Hado3728/Hado-Titan-v2/JOURNAL/SCREENSHOT DUMP/Laser cut gear system.jpeg

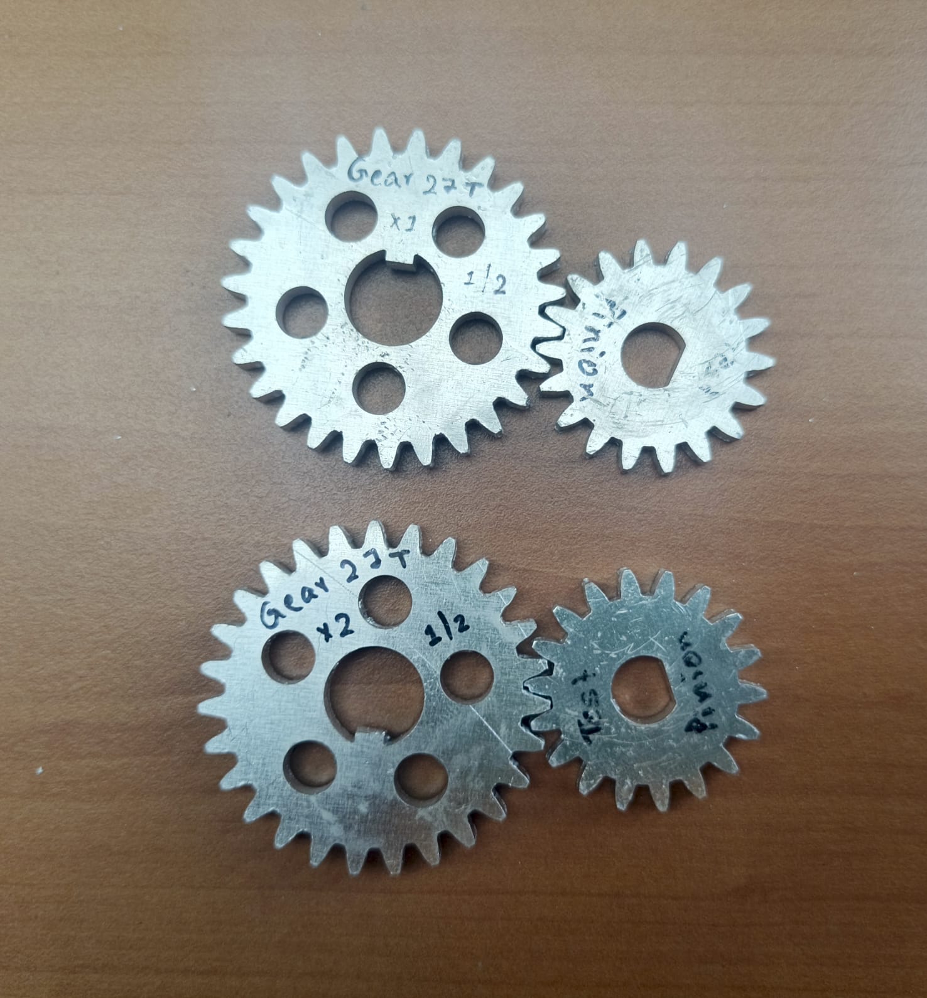
JOURNAL/SCREENSHOT DUMP/Laser cut gear system.jpeg
