Hado3728/Hado-Titan-v2/README.md

# Hado Titan V2

###### An 8 kg invertible drum spinner. The steel drum is belt driven and the chassis is laser-cut, bent sheet aluminium.



|Weight|7.78 kg of 8 kg (218 g spare, wiring included)|
|-|-|
|Size|386 × 268 × 100 mm|
|Weapon|Spinning drum|
|Weapon numbers|7,640 rpm, 539 J, 31 m/s at the tips, 0.9 s spin-up|
|Drive|2 × PG36M555 gearmotors  18:27 laser-cut gears|
|Battery|6S 2500 mAh 35C. A hard 5-minute fight.|

#### DRIVE GEAR SYSTEM (READY)

Laser cut gear system

## How it works

It basically is a two wheel driven combat bot, with a HR steel front single drum spinner with two protrusions. It is driven by a 5M HTD belt connected to a weapon motor inside the main bot. The weight distribution on to the ground is at two points, mainly the  wheels and the forks. The two wheels hold upto 75% of the total body weight of the bot whereas the forks hold the remaining weight. The order in which the bot works is that the forks elevate the opponent and then fed towards the drum spinner for the impact. The forks are shaped to work as a hook to latch on to the opponents to pull the other bot for maximum control. It is powered by a LiPO 6S 2500mah battery at the rear end of the bot which is protected with TPU fins about 30mm in length, and also the battery is also insulated with a EVA foam against the metal exterior.

## BOM

|Section|₹|
|-|-:|
|Electronics|29,817|
|Machining (CNC drum, heat treat, lathe parts)|12,241|
|Bought mechanical (bearings, belts, tyres, foam)|2,530|
|Wiring|2,417|
|Fasteners|1,771|
|Metal, laser cut + bent (₹375/kg)|1,621|
|3D printing (TPU)|1,360|
|Charger (only if needed)|3,043|
|Total|$616|

Approx value, it will prolly be lesser than $616 since i'm pitching my own allowance too (I already ordered the laser cut parts, and i even got em delivered) 

## Weight

|Group|g|
|-|-:|
|Drum, shaft, bearings, spacers|2326|
|Drive (gearmotors, gears, bulkheads, saddles)|1062|
|Tub, rear wall, splices|903|
|Wheels, axles, bearings, doublers|616|
|Weapon motor, pulley, belt, mount|613|
|Weapon uprights|602|
|Electronics|536|
|Lid|401|
|Fasteners|265|
|Forks|164|
|TPU cradles + foam|154|
|Wiring|140|
|Total|7782|
THESE HAVE CHANGED (SO ABOUT 100 GM +-) 

ALL THE LASER CUT PARTS DELIVERED
WhatsApp Image 2026-11-10 at 12 16 42 PM
