Hado3728/Hado-Titan-v2/JOURNAL/SCREENSHOT DUMP/BOM3.png

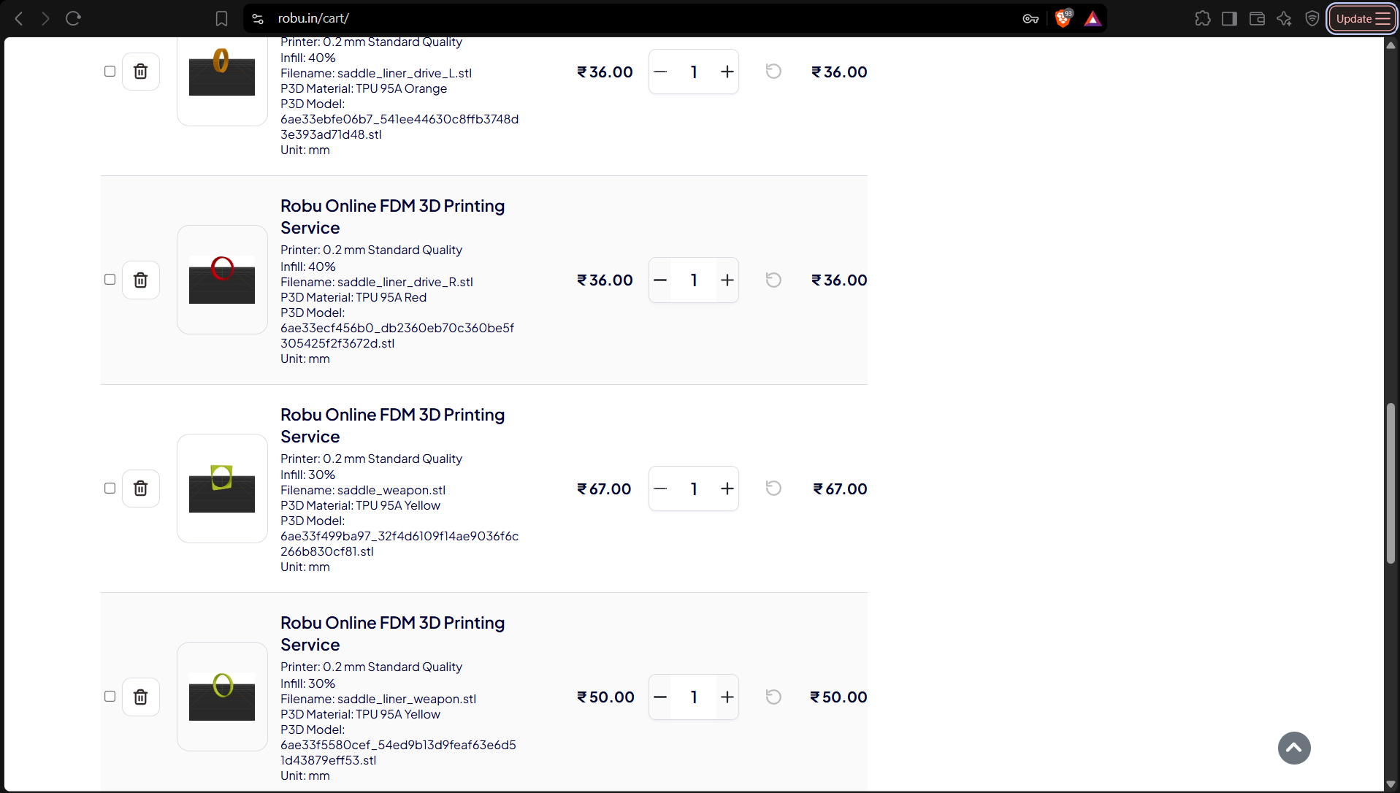
JOURNAL/SCREENSHOT DUMP/BOM3.png
