Hado3728/Hado-Titan-v2/JOURNAL/SCREENSHOT DUMP/BOM4.png

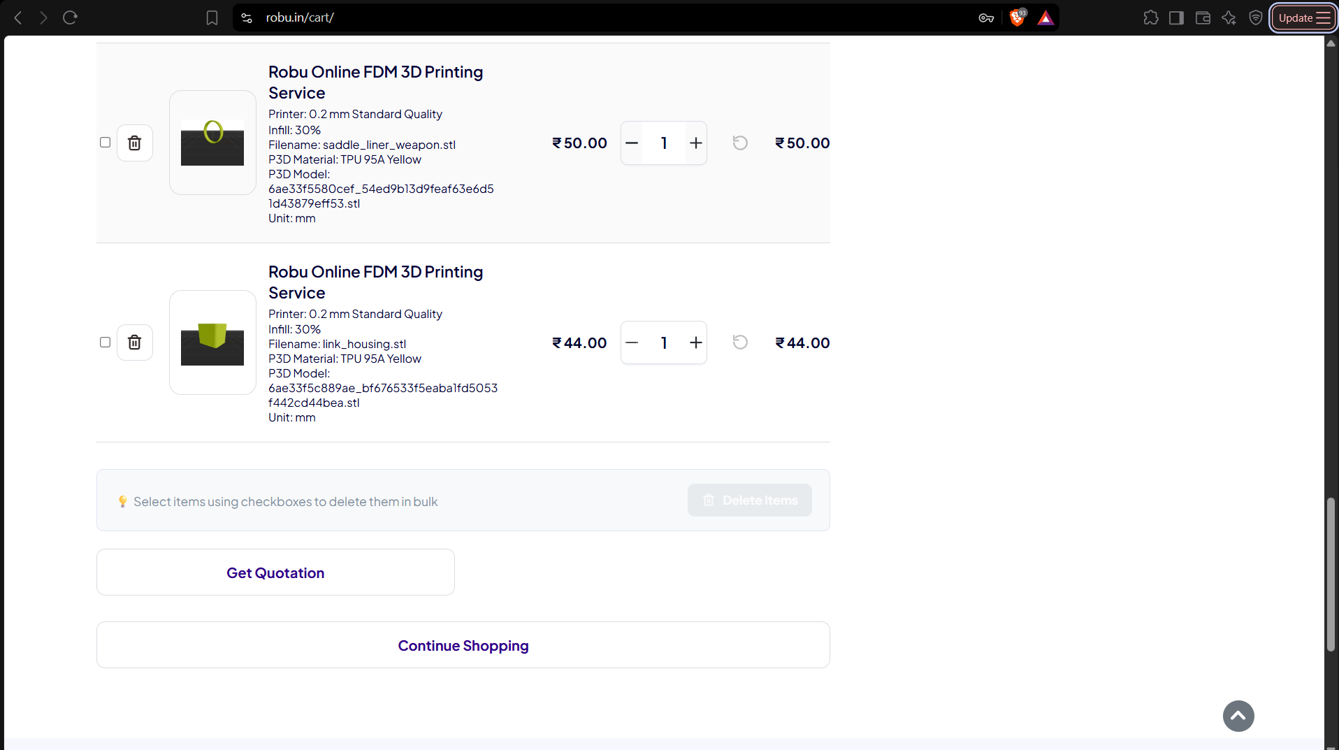
JOURNAL/SCREENSHOT DUMP/BOM4.png
