Hado3728/Hado-Titan-v2/CAD/hado_titan_v2_assembly.step

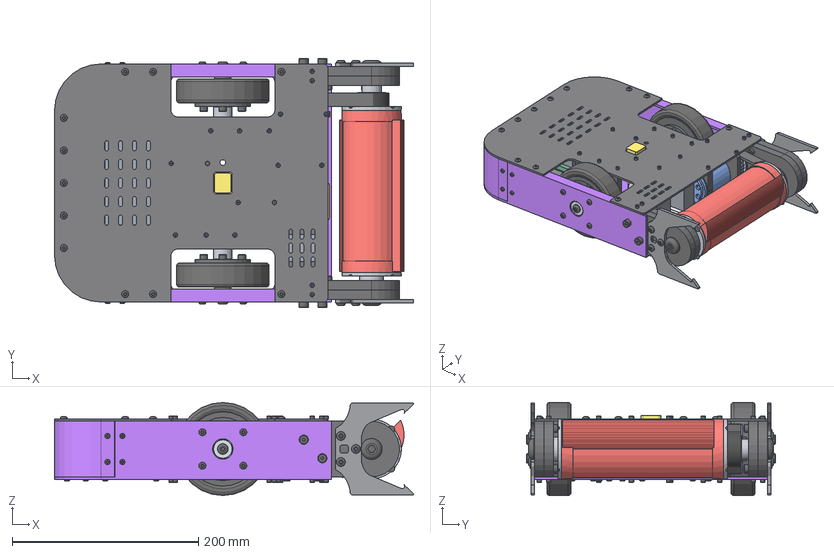
[picture p6: CAD file, 2026-11-03]
CAD/hado_titan_v2_assembly.step
386.0 x 268.0 x 100.0 mm
tub
lid
upright_inner_L
upright_outer_L
upright_inner_R
upright_outer_R
fork_L
fork_R
bearing_drum_L
belt
weapon_motor
weapon_mount
saddle_weapon
saddle_liner_weapon
gearmotor_L
gearmotor_R
bulkhead_L
bulkhead_R
axle_L
bearing_axle_in_L
bearing_axle_out_L
spacer_axle_out_L
doubler_L
retainer_L
washer_axle_L
axle_R
bearing_axle_in_R
bearing_axle_out_R
spacer_axle_out_R
doubler_R
retainer_R
washer_axle_R
saddle_drive_L
saddle_liner_drive_L
saddle_drive_R
saddle_liner_drive_R
cradle_mdds10
foam_mdds10
mdds10
cradle_battery
foam_battery
battery
cradle_zerodrag
foam_zerodrag
zerodrag
cradle_receiver
foam_receiver
receiver
link_housing
link_plug
screw_lid_1
screw_lid_2
screw_lid_3
screw_lid_4
screw_lid_5
screw_lid_6
screw_lid_7
screw_lid_8
screw_lid_9
screw_lid_10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
