Hado3728/Hado-Titan-v2/CAD/3D PRINT SKIRT/side_fin_skirt_R_TPU.step

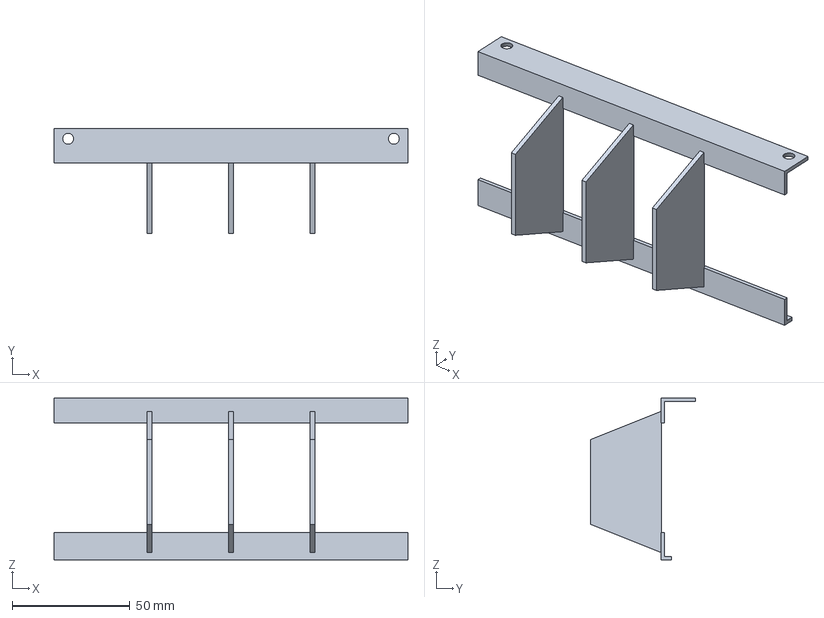
[picture p7: CAD file, 2026-11-03]
CAD/3D PRINT SKIRT/side_fin_skirt_R_TPU.step
150.0 x 44.3 x 68.5 mm
