Hado3728/Hado-Titan-v2/CAD/PARTS/axle_L.step

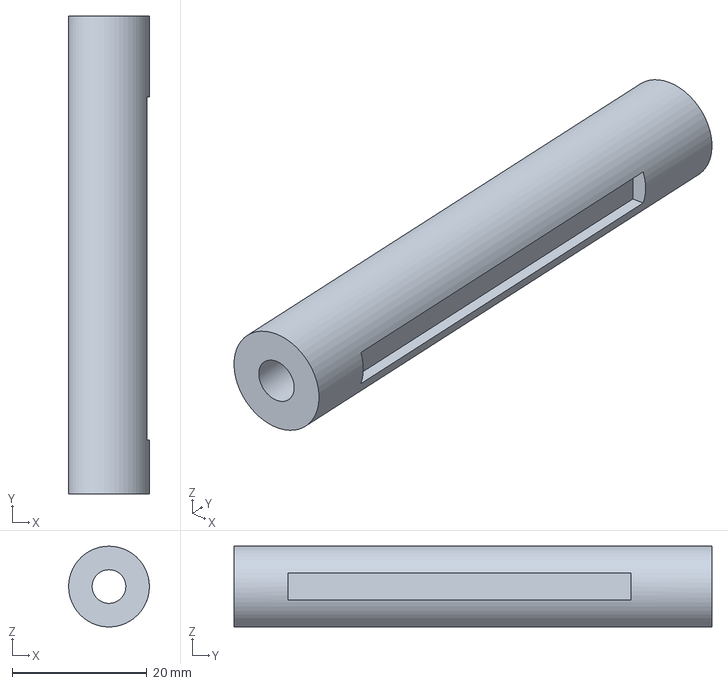
[picture p8: CAD file, 2026-11-03]
CAD/PARTS/axle_L.step
12.0 x 71.0 x 12.0 mm
