Hado3728/Hado-Titan-v2/CAD/PROTECTIVE SLEEVES/drum_tooth_sleeve_TPU_x2.step

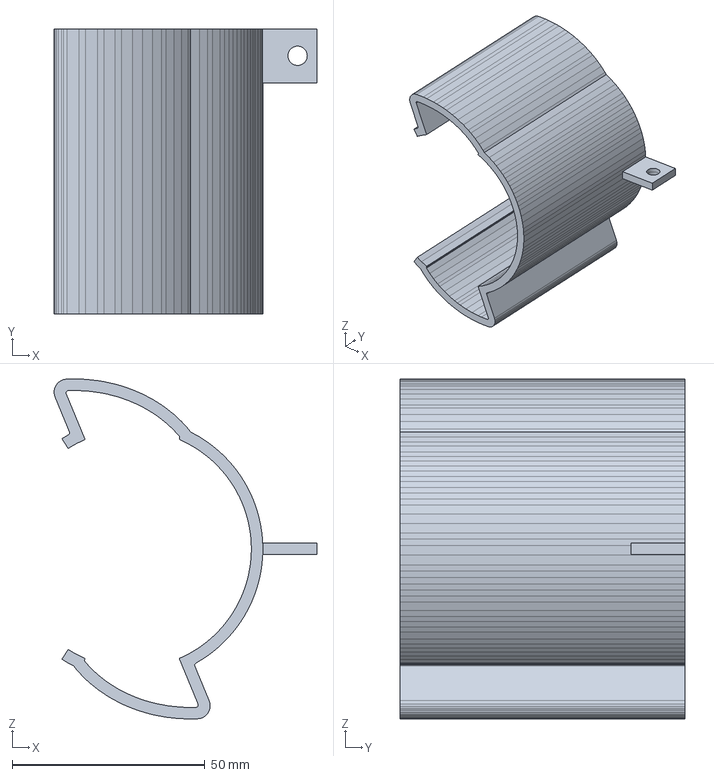
[picture p9: CAD file, 2026-11-03]
CAD/PROTECTIVE SLEEVES/drum_tooth_sleeve_TPU_x2.step
68.1 x 74.0 x 88.1 mm
