Hado3728/Hado-Titan-v2/CAD/PARTS/cradle_mdds10.step

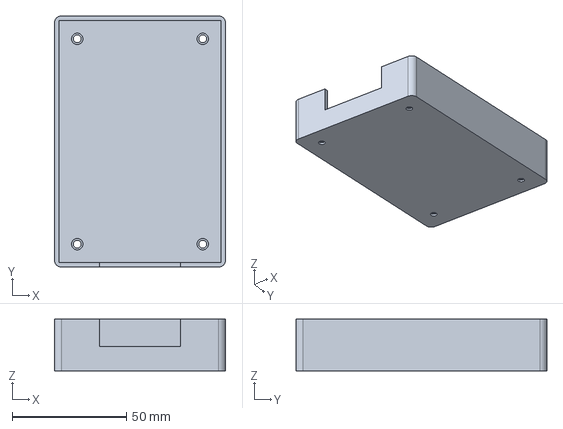
[picture p10: CAD file, 2026-11-03]
CAD/PARTS/cradle_mdds10.step
75.0 x 110.0 x 22.8 mm
