Hado3728/Hado-Titan-v2/CAD/PROTECTIVE SLEEVES/fork_tip_clip_TPU_x4.step

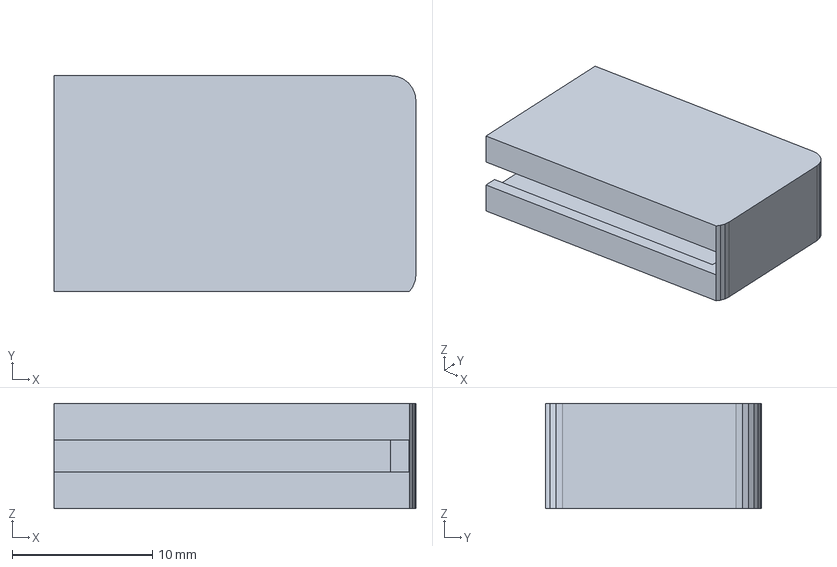
[picture p11: CAD file, 2026-11-03]
CAD/PROTECTIVE SLEEVES/fork_tip_clip_TPU_x4.step
25.8 x 15.4 x 7.50 mm
