Hado3728/Hado-Titan-v2/CAD/3D PRINT SKIRT/rear_fin_skirt_TPU.step

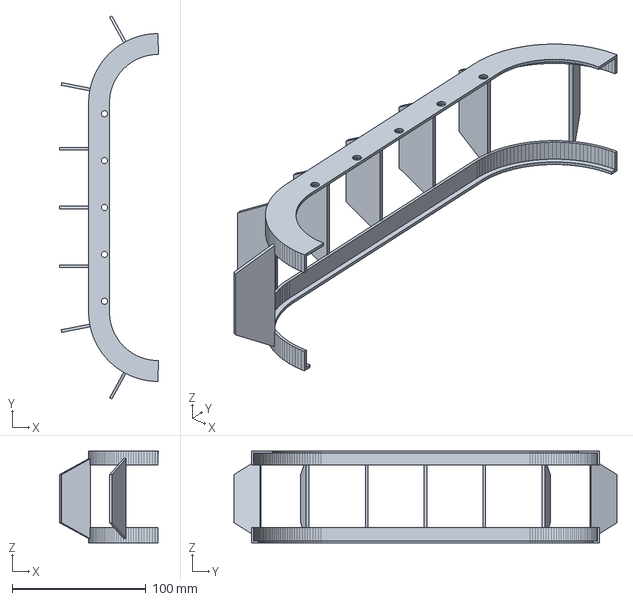
[picture p12: CAD file, 2026-11-03]
CAD/3D PRINT SKIRT/rear_fin_skirt_TPU.step
73.8 x 286.0 x 68.5 mm
