Hado3728/Hado-Titan-v2/CAD/PARTS/saddle_liner_drive_R.step

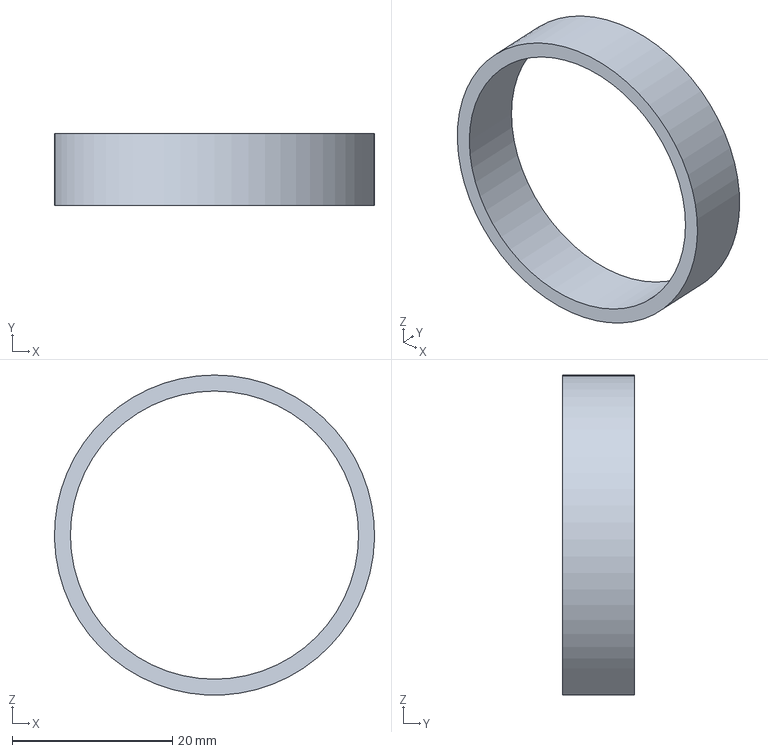
[picture p13: CAD file, 2026-11-03]
CAD/PARTS/saddle_liner_drive_R.step
40.0 x 9.00 x 40.0 mm
