Hado3728/Hado-Titan-v2/CAD/PARTS/retainer_R.step

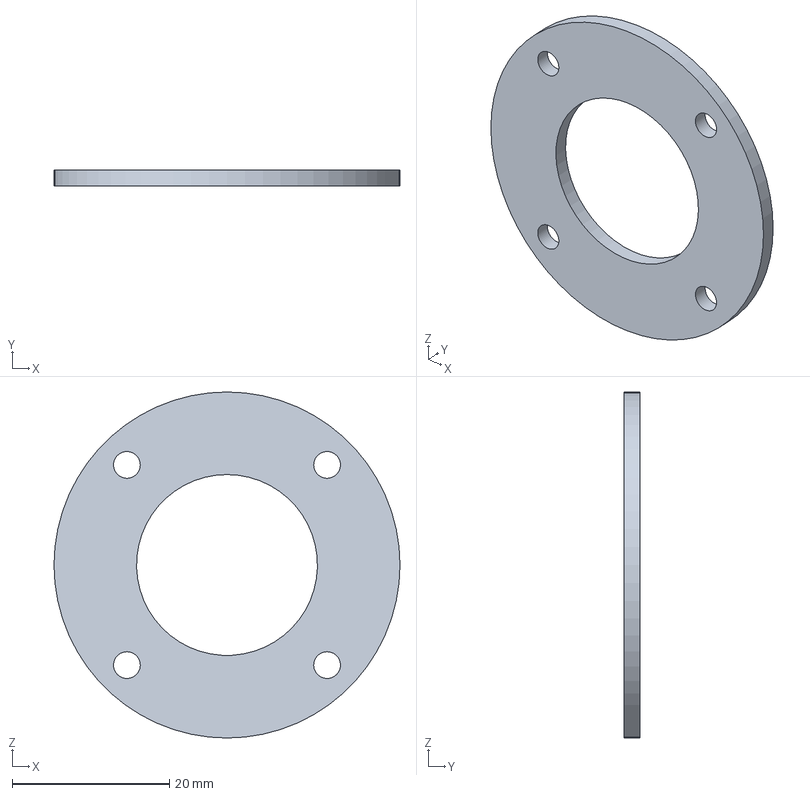
[picture p14: CAD file, 2026-11-03]
CAD/PARTS/retainer_R.step
44.0 x 2.00 x 44.0 mm
