Hado3728/Hado-Titan-v2/CAD/PARTS/tub.step

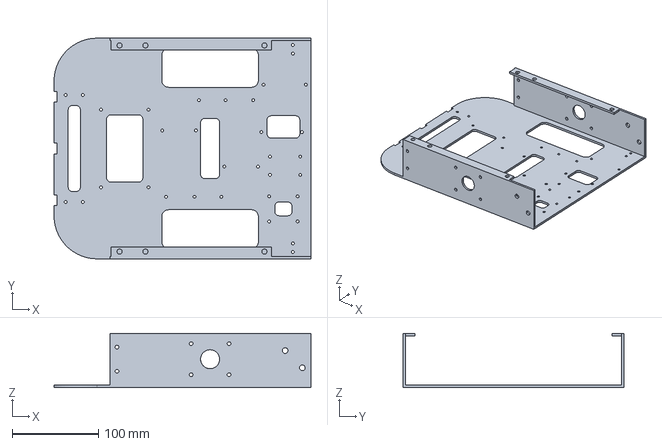
[picture p15: CAD file, 2026-11-03]
CAD/PARTS/tub.step
298.0 x 256.0 x 63.0 mm
