Hado3728/Hado-Titan-v2/CAD/PARTS/spacer_drum_L.step

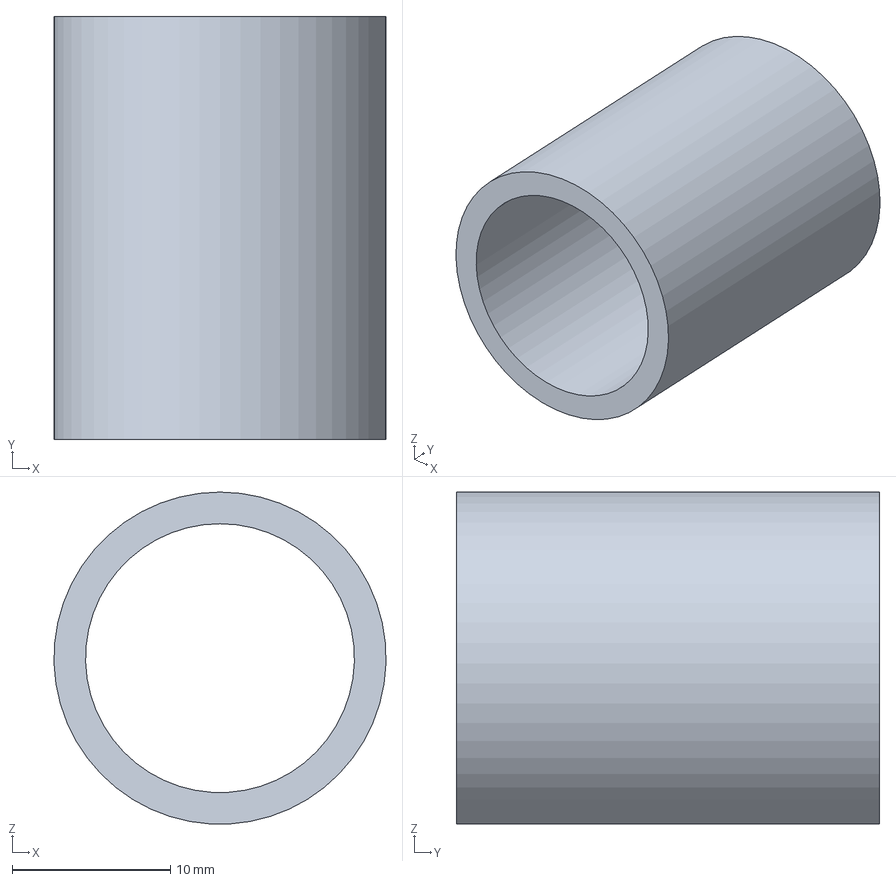
[picture p16: CAD file, 2026-11-03]
CAD/PARTS/spacer_drum_L.step
21.0 x 26.8 x 21.0 mm
