Hado3728/Hado-Titan-v2/CAD/PARTS/belt.step

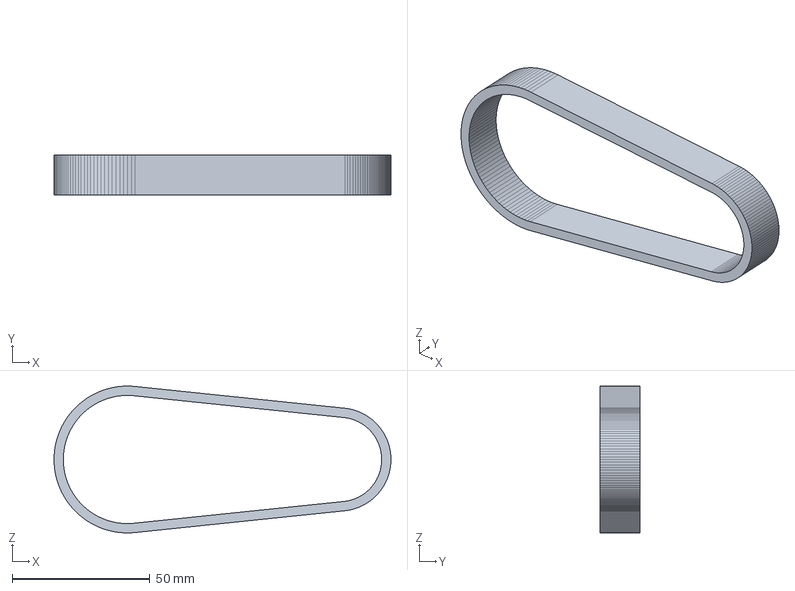
[picture p17: CAD file, 2026-11-03]
CAD/PARTS/belt.step
122.5 x 14.6 x 53.4 mm
