Hado3728/Hado-Titan-v2/CAD/PARTS/motor_pulley_hub.step

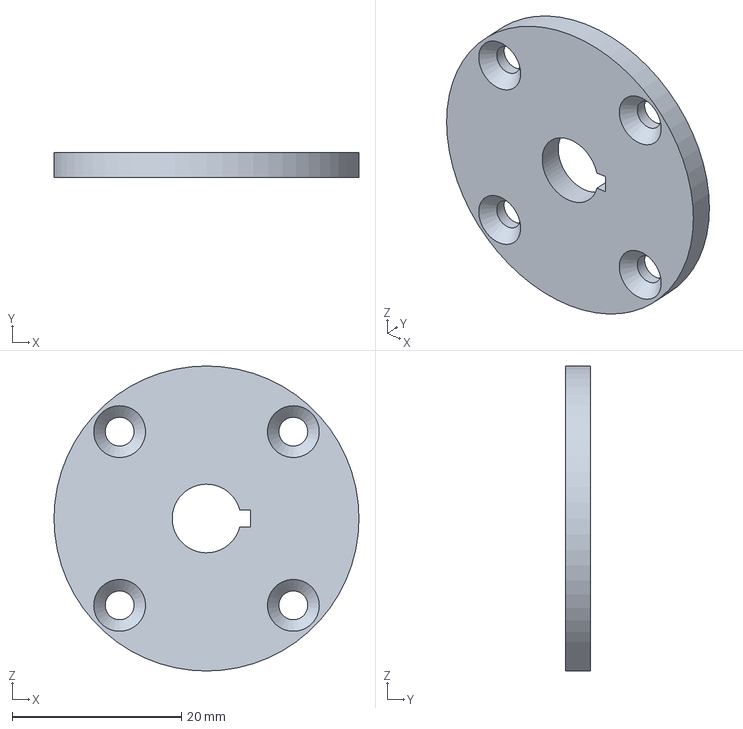
[picture p18: CAD file, 2026-11-03]
CAD/PARTS/motor_pulley_hub.step
36.0 x 3.00 x 36.0 mm
