Hado3728/Hado-Titan-v2/CAD/PARTS/splice_L.step

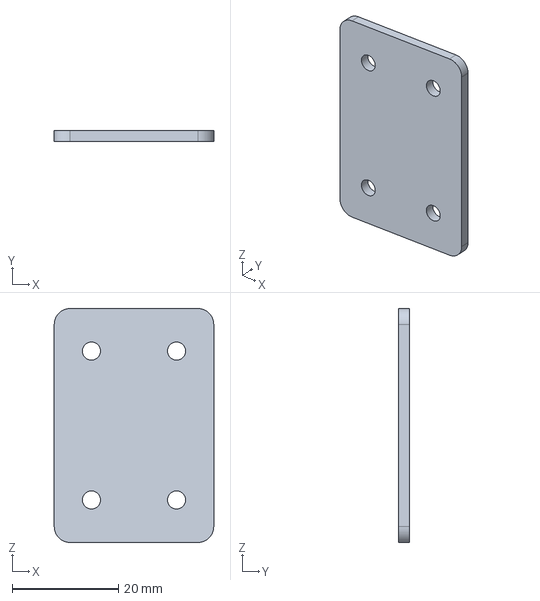
[picture p19: CAD file, 2026-11-03]
CAD/PARTS/splice_L.step
30.0 x 2.00 x 44.0 mm
