Hado3728/Hado-Titan-v2/CAD/PARTS/upright_outer_R.step

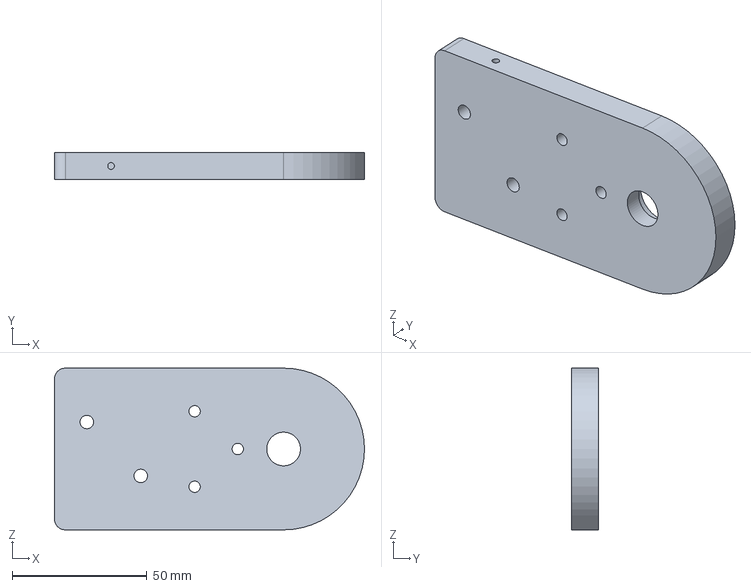
[picture p20: CAD file, 2026-11-03]
CAD/PARTS/upright_outer_R.step
115.0 x 10.0 x 60.0 mm
