Hado3728/Hado-Titan-v2/CAD/PARTS/pinion_L.step

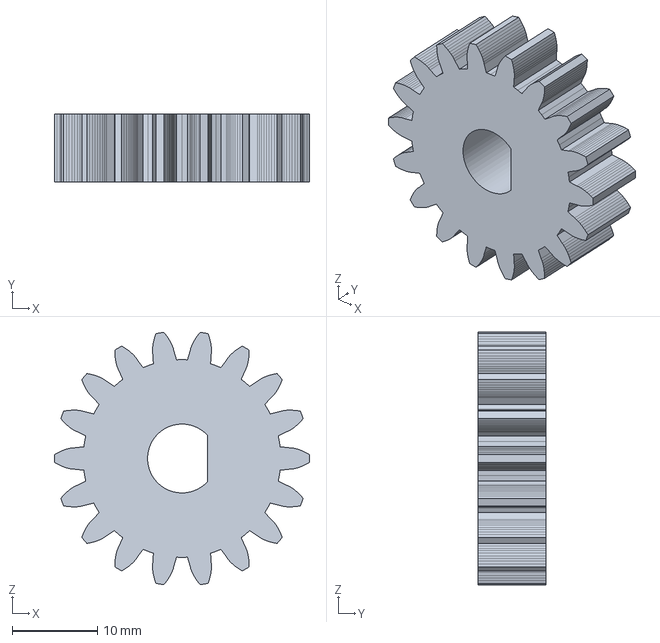
[picture p21: CAD file, 2026-11-03]
CAD/PARTS/pinion_L.step
30.0 x 8.00 x 29.7 mm
