Hado3728/Hado-Titan-v2/CAD/PARTS/motor_pulley_tooth_2.step

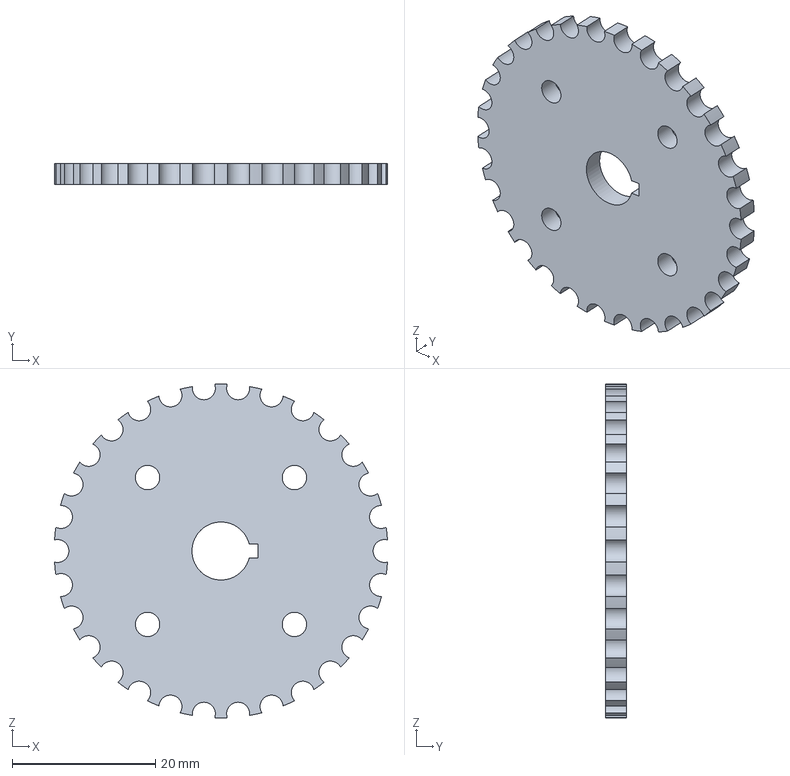
[picture p22: CAD file, 2026-11-03]
CAD/PARTS/motor_pulley_tooth_2.step
46.5 x 3.00 x 46.6 mm
