Hado3728/Hado-Titan-v2/CAD/PARTS/motor_pulley_flange_out.step

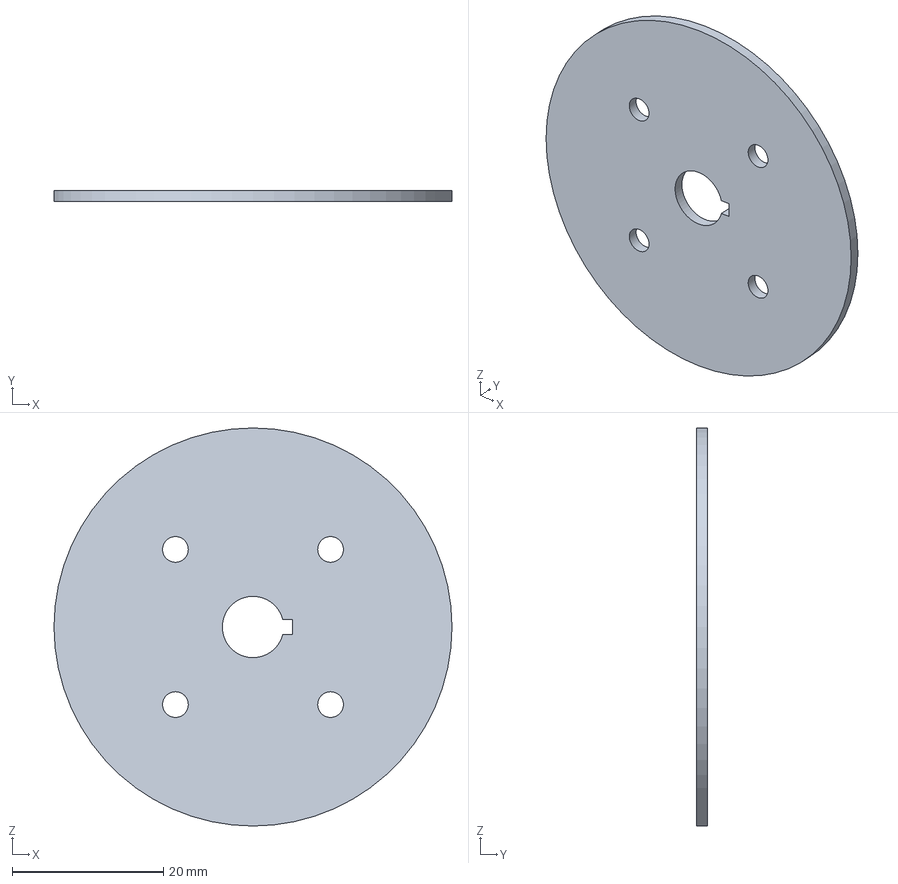
[picture p23: CAD file, 2026-11-03]
CAD/PARTS/motor_pulley_flange_out.step
52.6 x 1.50 x 52.6 mm
