Hado3728/Hado-Titan-v2/CAD/PARTS/fork_L.step

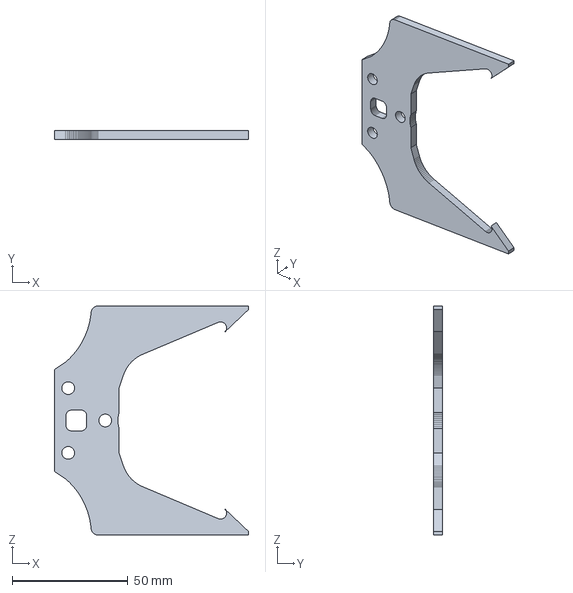
[picture p24: CAD file, 2026-11-03]
CAD/PARTS/fork_L.step
84.0 x 4.00 x 99.0 mm
