Hado3728/Hado-Titan-v2/CAD/PARTS/drum.step

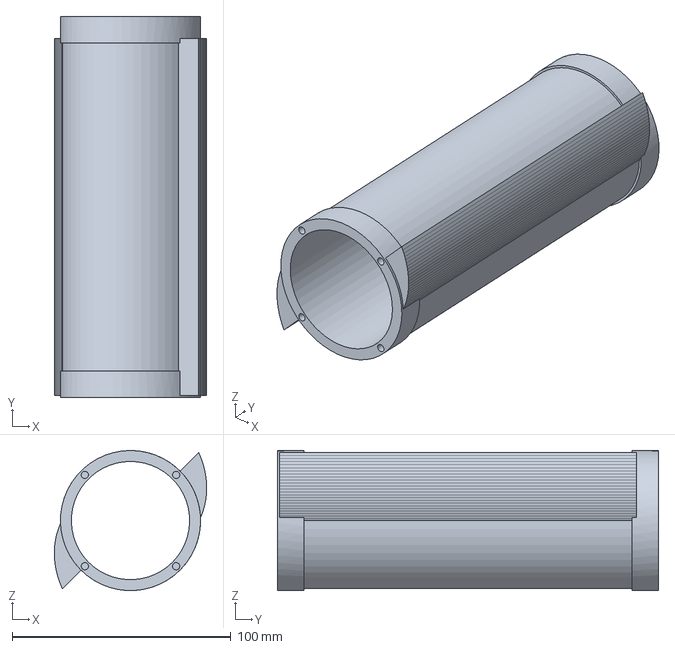
[picture p25: CAD file, 2026-11-03]
CAD/PARTS/drum.step
69.6 x 174.0 x 64.0 mm
