Hado3728/Hado-Titan-v2/CAD/PARTS/bulkhead_L.step

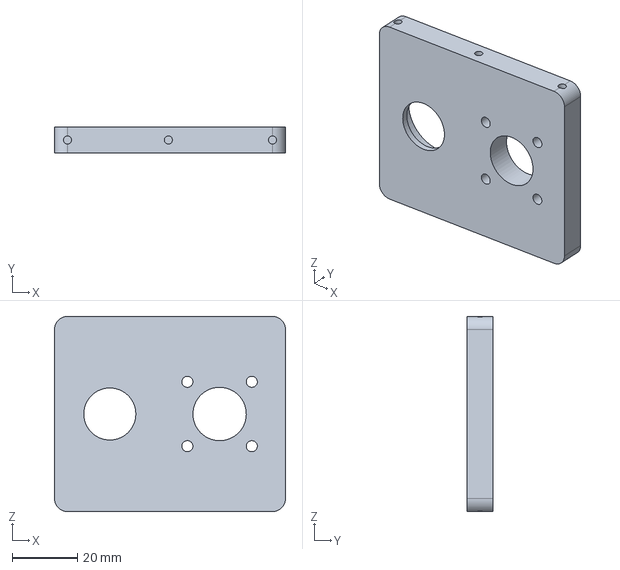
[picture p26: CAD file, 2026-11-03]
CAD/PARTS/bulkhead_L.step
71.0 x 8.00 x 60.0 mm
