Hado3728/Hado-Titan-v2/CAD/PARTS/drum_cap_R.step

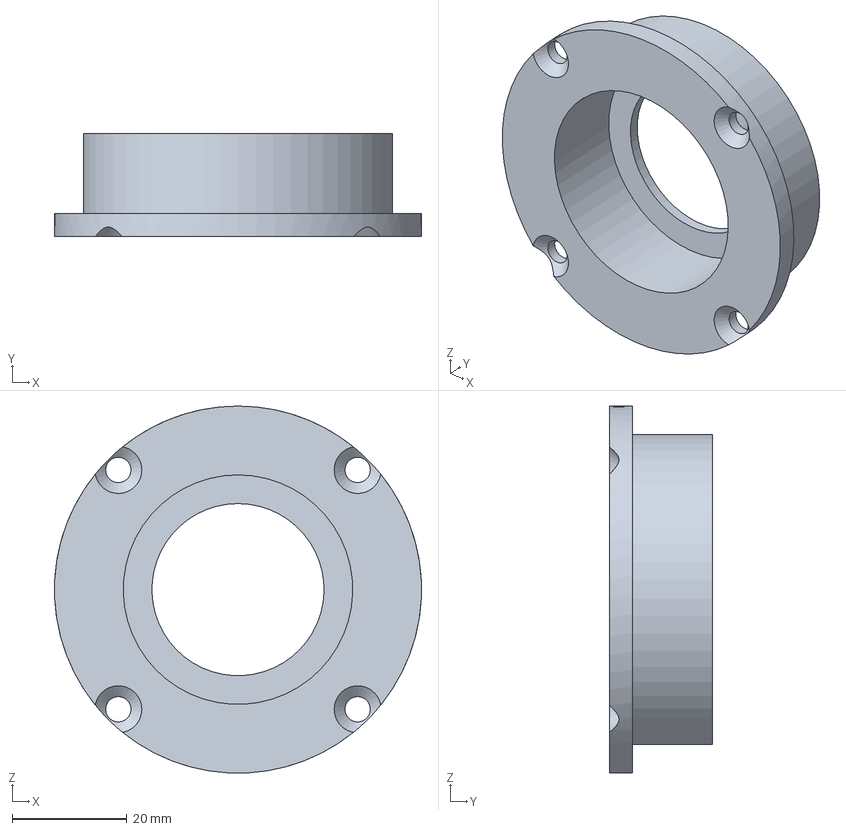
[picture p27: CAD file, 2026-11-03]
CAD/PARTS/drum_cap_R.step
64.0 x 18.0 x 64.0 mm
