Hado3728/Hado-Titan-v2/CAD/PARTS/saddle_liner_weapon.step

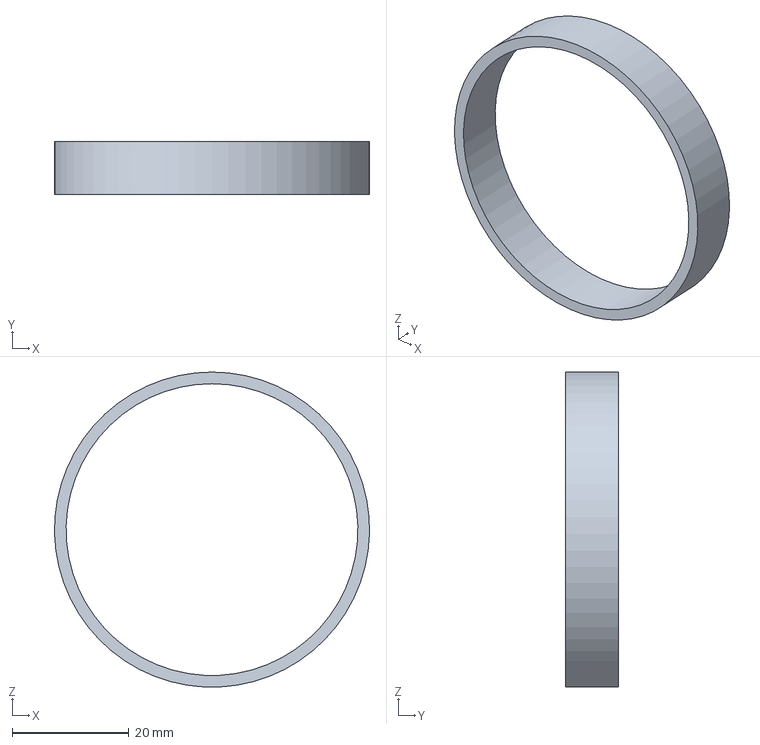
[picture p28: CAD file, 2026-11-03]
CAD/PARTS/saddle_liner_weapon.step
54.0 x 9.00 x 54.0 mm
