Hado3728/Hado-Titan-v2/CAD/PARTS/spacer_axle_R.step

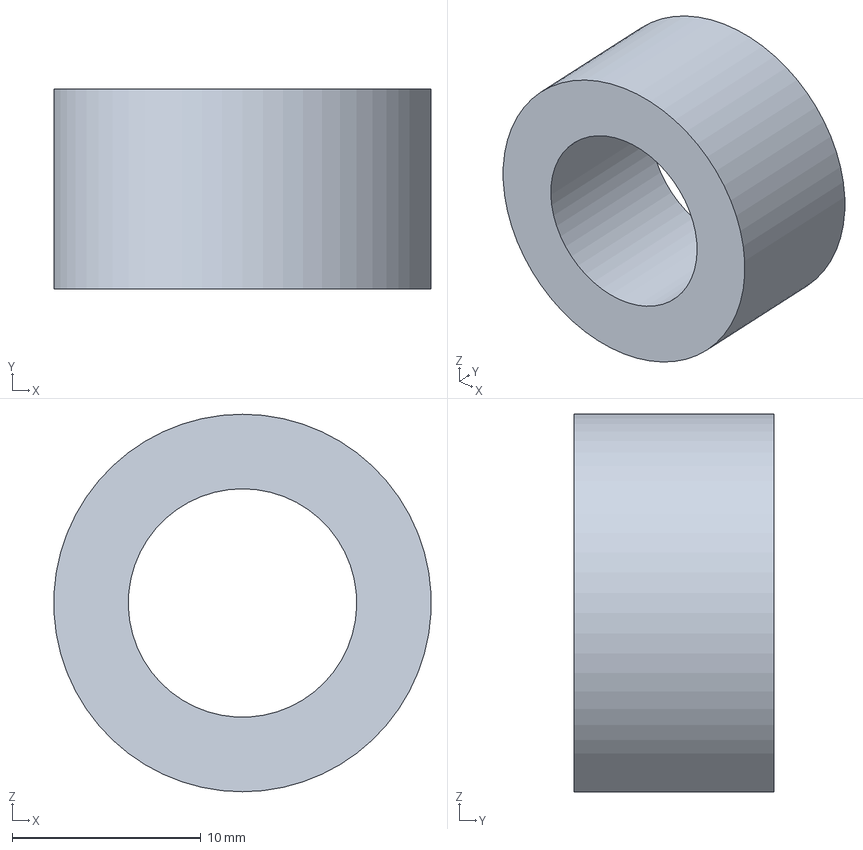
[picture p29: CAD file, 2026-11-03]
CAD/PARTS/spacer_axle_R.step
20.0 x 10.6 x 20.0 mm
