Hado3728/Hado-Titan-v2/CAD/PARTS/spacer_axle_out_R.step

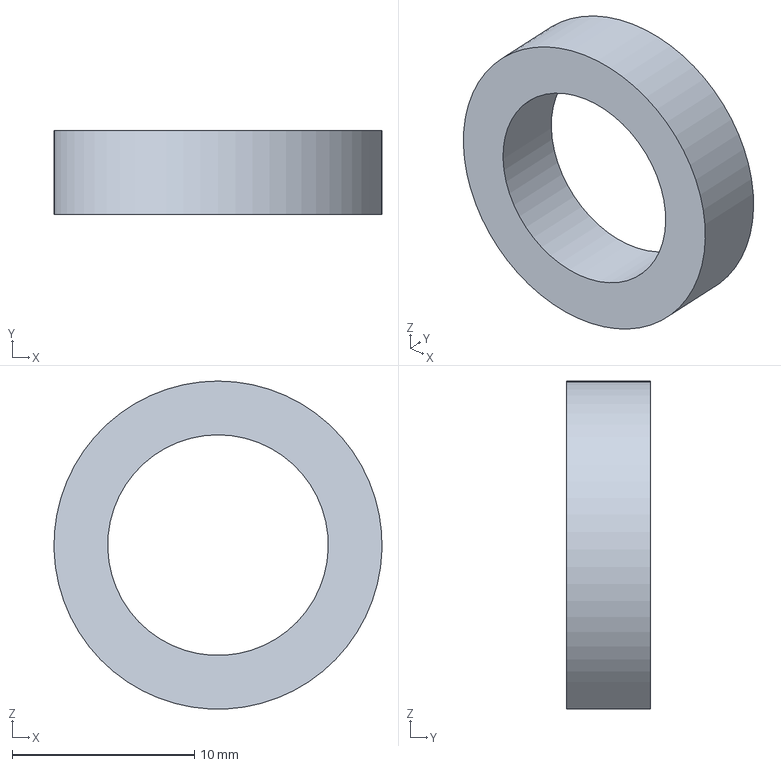
[picture p30: CAD file, 2026-11-03]
CAD/PARTS/spacer_axle_out_R.step
18.0 x 4.60 x 18.0 mm
