Hado3728/Hado-Titan-v2/CAD/PARTS/spacer_drum_R.step

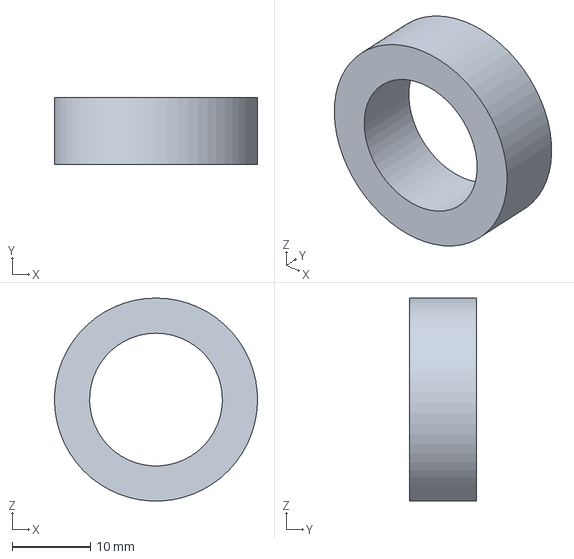
[picture p31: CAD file, 2026-11-03]
CAD/PARTS/spacer_drum_R.step
26.0 x 8.60 x 26.0 mm
