Hado3728/Hado-Titan-v2/CAD/PARTS/drum_cap_L.step

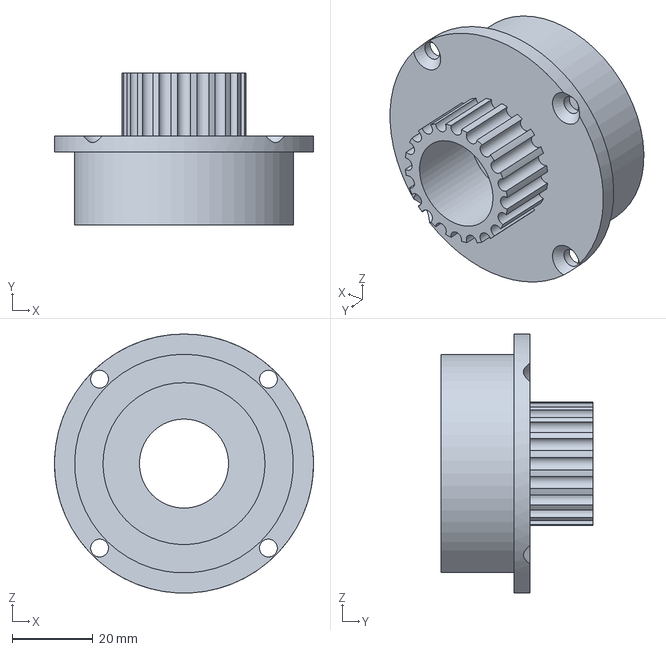
[picture p32: CAD file, 2026-11-03]
CAD/PARTS/drum_cap_L.step
64.0 x 37.5 x 64.0 mm
