Hado3728/Hado-Titan-v2/CAD/PARTS/drum_shaft.step

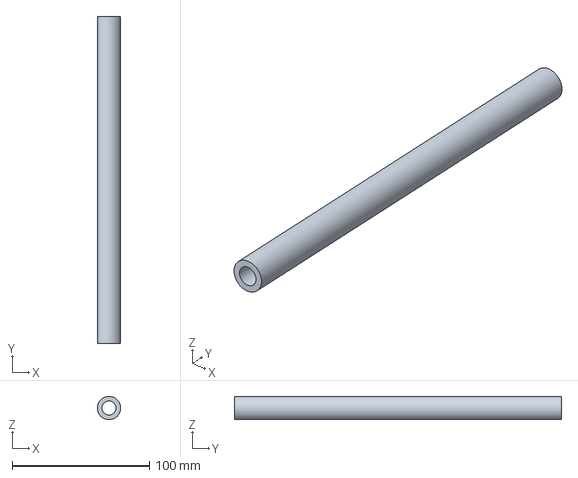
[picture p33: CAD file, 2026-11-03]
CAD/PARTS/drum_shaft.step
17.0 x 238.0 x 17.0 mm
