Hado3728/Hado-Titan-v2/CAD/PARTS/weapon_mount.step

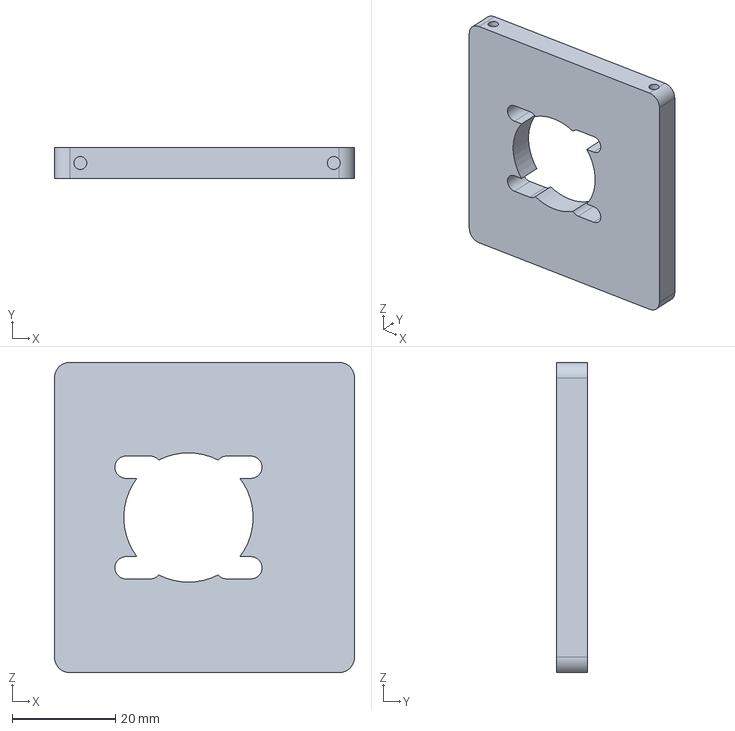
[picture p34: CAD file, 2026-11-03]
CAD/PARTS/weapon_mount.step
58.0 x 6.00 x 60.0 mm
