Hado3728/Hado-Titan-v2/CAD/PARTS/saddle_drive_R.step

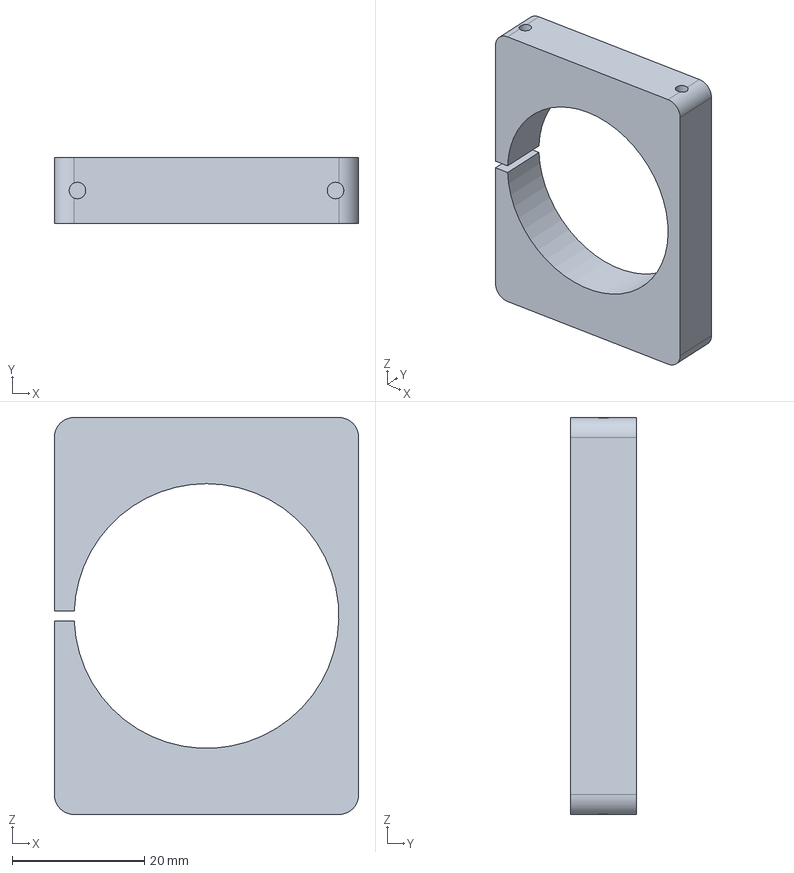
[picture p36: CAD file, 2026-11-03]
CAD/PARTS/saddle_drive_R.step
46.0 x 10.0 x 60.0 mm
