Hado3728/Hado-Titan-v2/CAD/PARTS/gear_R.step

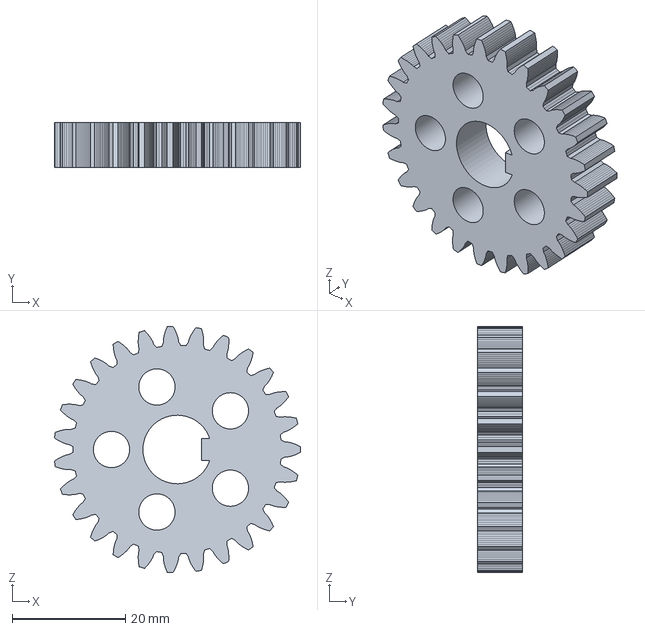
[picture p37: CAD file, 2026-11-03]
CAD/PARTS/gear_R.step
43.4 x 8.00 x 43.5 mm
