Hado3728/Hado-Titan-v2/CAD/PARTS/drive_plate_R.step

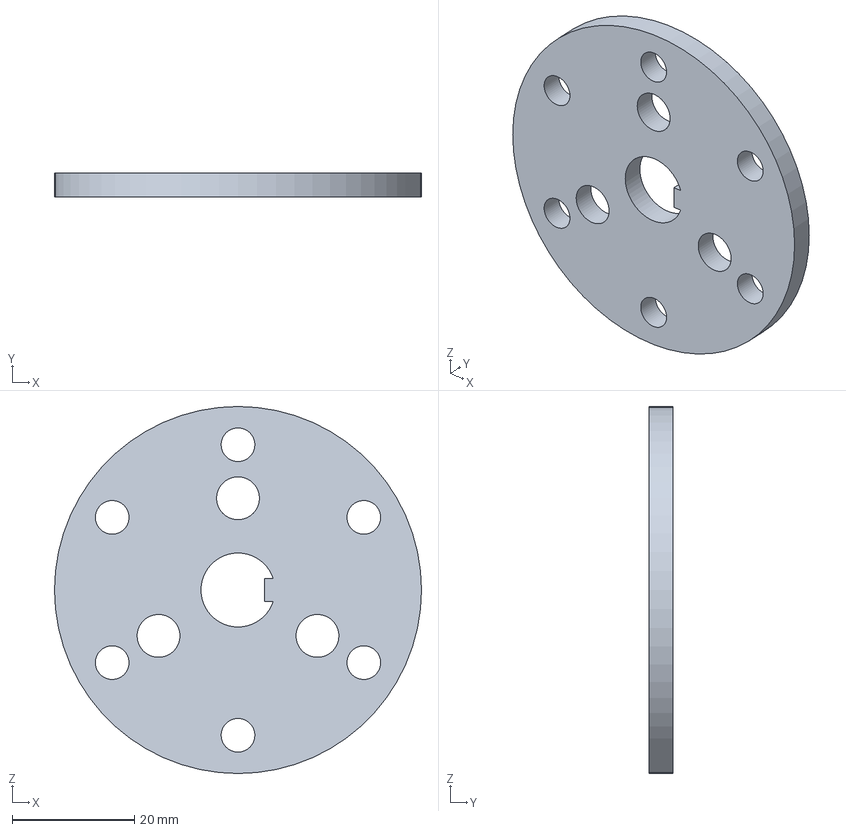
[picture p38: CAD file, 2026-11-03]
CAD/PARTS/drive_plate_R.step
60.0 x 4.00 x 60.0 mm
