Hado3728/Hado-Titan-v2/CAD/PARTS/doubler_L.step

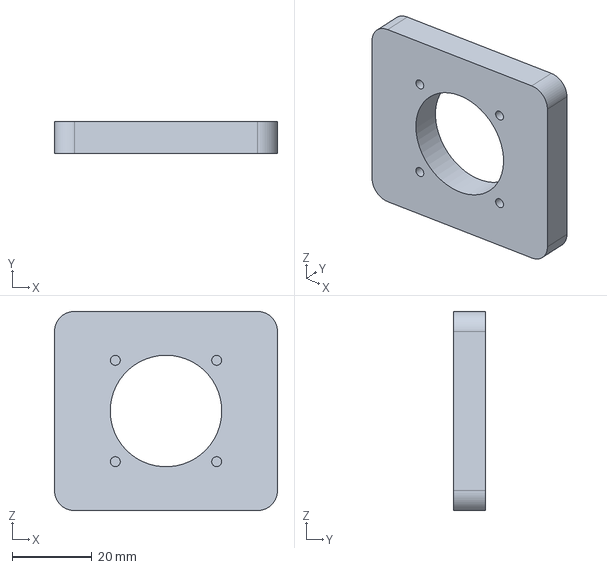
[picture p39: CAD file, 2026-11-03]
CAD/PARTS/doubler_L.step
56.0 x 8.00 x 50.0 mm
