Hado3728/Hado-Titan-v2/CAD/PARTS/cradle_receiver.step

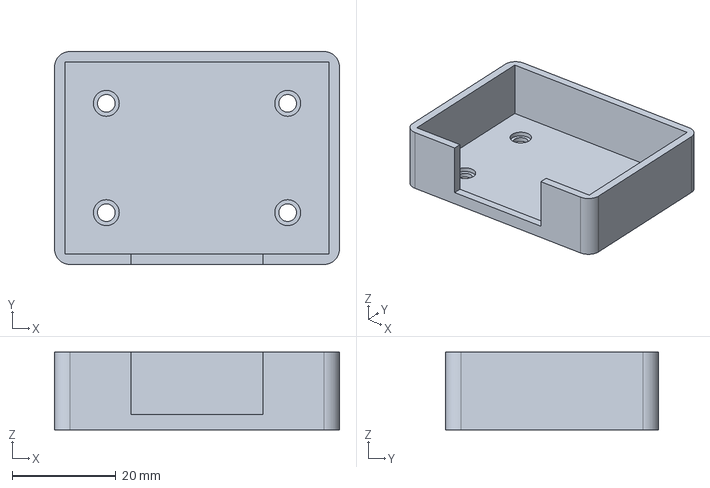
[picture p40: CAD file, 2026-11-03]
CAD/PARTS/cradle_receiver.step
55.0 x 41.1 x 15.0 mm
