Hado3728/Hado-Titan-v2/CAD/PARTS/rear_wall.step

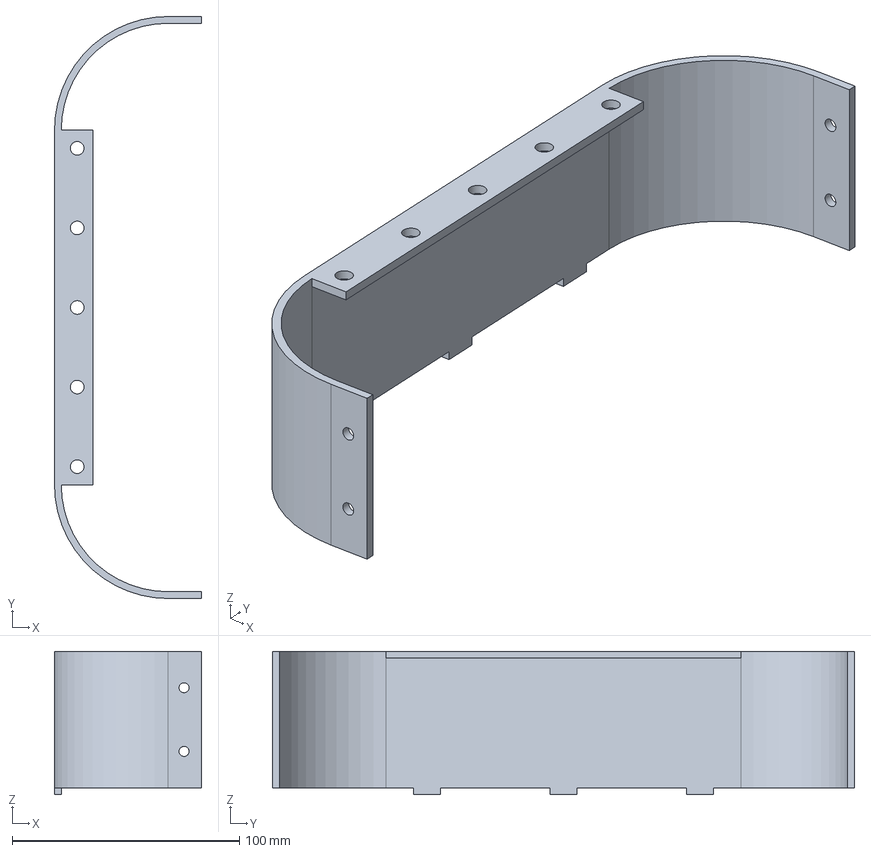
[picture p41: CAD file, 2026-11-03]
CAD/PARTS/rear_wall.step
64.7 x 256.0 x 63.0 mm
