Hado3728/Hado-Titan-v2/CAD/PARTS/cradle_battery.step

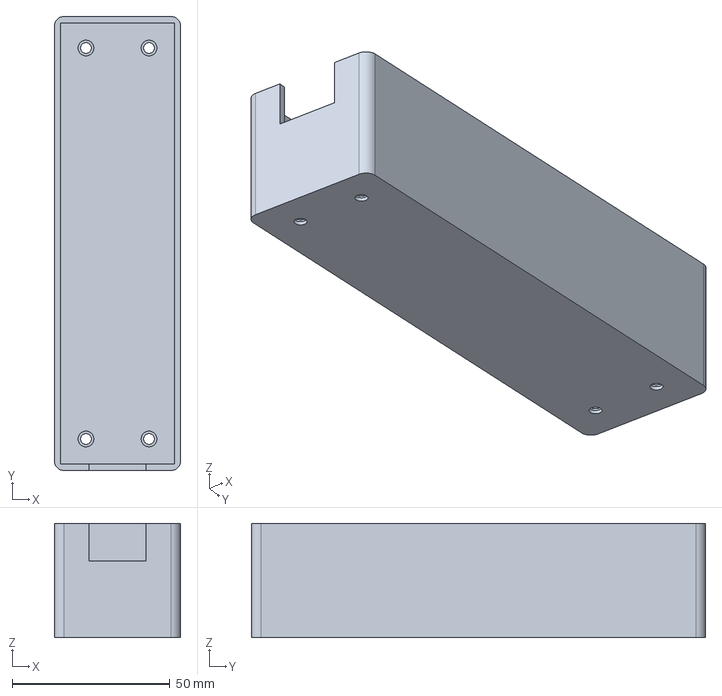
[picture p42: CAD file, 2026-11-03]
CAD/PARTS/cradle_battery.step
40.0 x 144.0 x 36.2 mm
