Hado3728/Hado-Titan-v2/CAD/PARTS/saddle_weapon.step

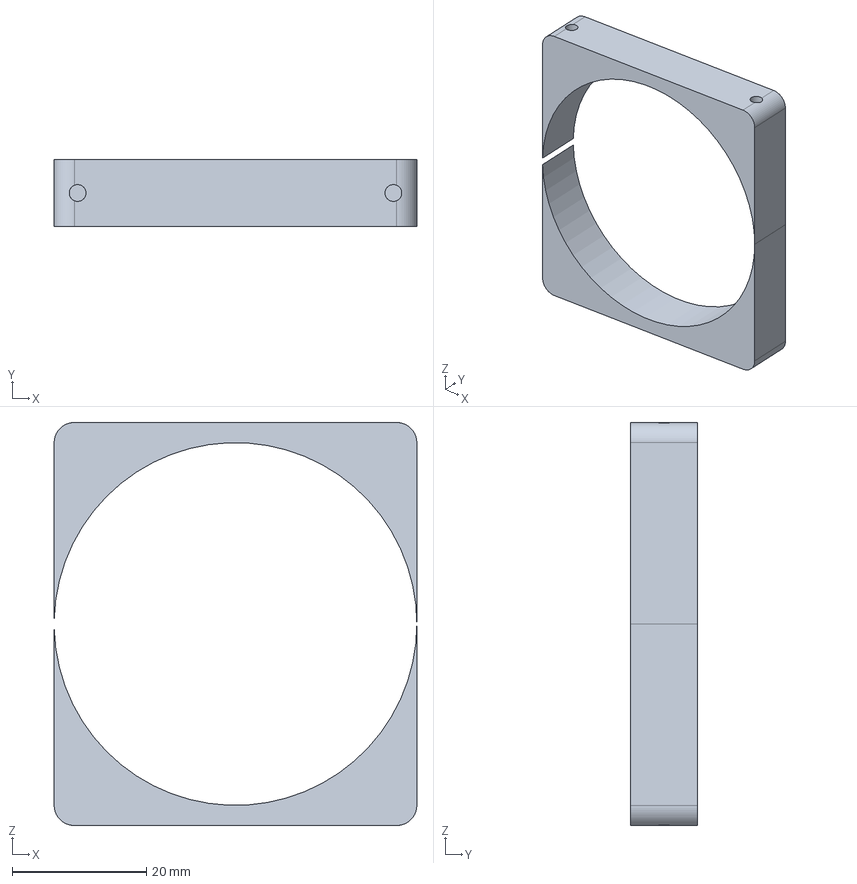
[picture p43: CAD file, 2026-11-03]
CAD/PARTS/saddle_weapon.step
54.0 x 10.0 x 60.0 mm
