Hado3728/Hado-Titan-v2/CAD/PARTS/cradle_zerodrag.step

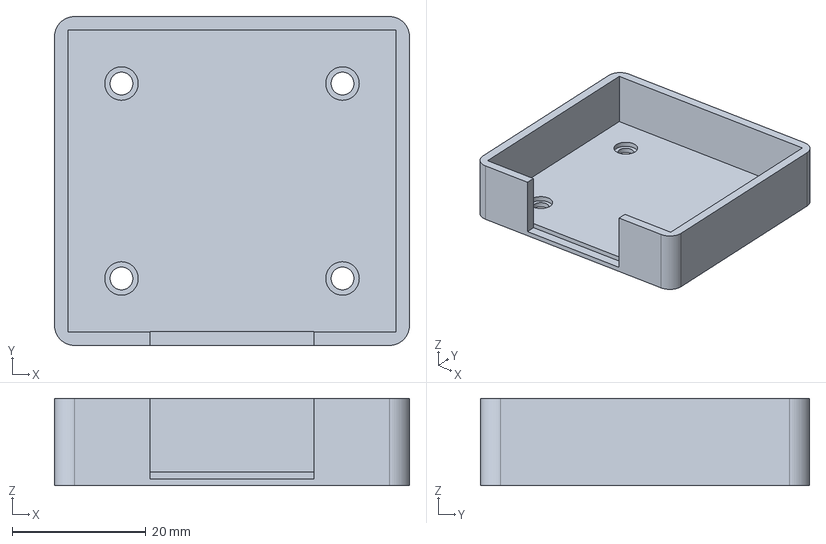
[picture p44: CAD file, 2026-11-03]
CAD/PARTS/cradle_zerodrag.step
53.0 x 49.1 x 13.0 mm
