Hado3728/Hado-Titan-v2/CAD/PARTS/lid.step

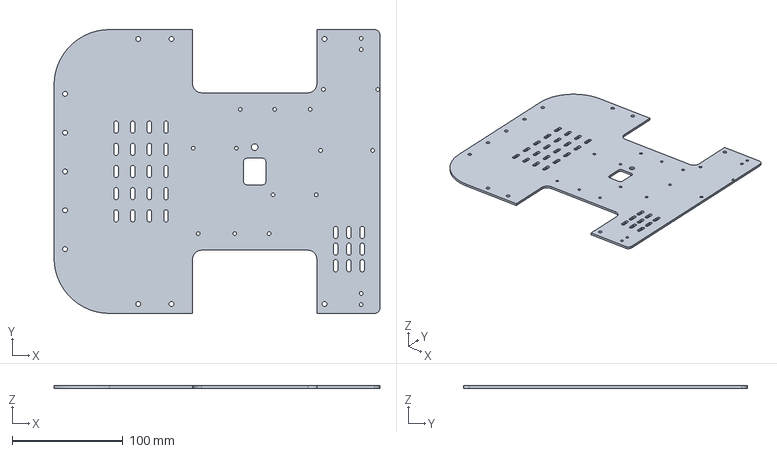
[picture p45: CAD file, 2026-11-03]
CAD/PARTS/lid.step
294.0 x 256.0 x 2.50 mm
