Hado3728/Hado-Titan-v2/CAD/PARTS/link_housing.step

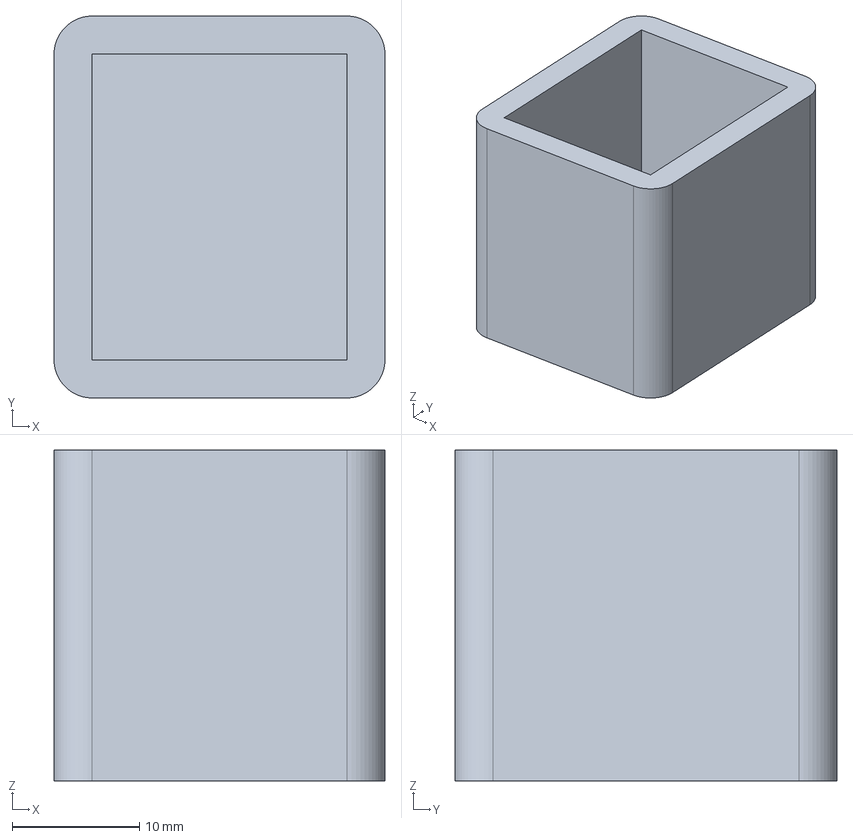
[picture p46: CAD file, 2026-11-03]
CAD/PARTS/link_housing.step
26.0 x 30.0 x 26.0 mm
