Hado3728/Hado-Titan-v2/(list of files, cad)

Other CAD files:
CAD/3D PRINT SKIRT/side_fin_skirt_L_TPU.step
CAD/PARTS/saddle_liner_drive_L.step
CAD/PARTS/motor_pulley_tooth_4.step
CAD/PARTS/motor_pulley_tooth_3.step
CAD/PARTS/upright_outer_L.step
CAD/PARTS/motor_pulley_tooth_5.step
CAD/PARTS/motor_pulley_flange_in.step
CAD/PARTS/axle_R.step
CAD/PARTS/spacer_axle_L.step
CAD/PARTS/upright_inner_L.step
CAD/PARTS/pinion_R.step
CAD/PARTS/drive_plate_L.step
CAD/PARTS/bulkhead_R.step
CAD/PARTS/motor_pulley_tooth_1.step
CAD/PARTS/doubler_R.step
CAD/PARTS/fork_R.step
CAD/PARTS/saddle_drive_L.step
CAD/PARTS/splice_R.step
CAD/PARTS/gear_L.step
CAD/PARTS/retainer_L.step
CAD/PARTS/spacer_axle_out_L.step
CAD/PARTS/nut_mpulley_1.step
CAD/PARTS/nut_mpulley_2.step
CAD/PARTS/nut_mpulley_3.step
CAD/PARTS/nut_mpulley_4.step
CAD/PARTS/nut_wheel_L1.step
CAD/PARTS/nut_wheel_L2.step
CAD/PARTS/nut_wheel_L3.step
CAD/PARTS/nut_wheel_L4.step
CAD/PARTS/nut_wheel_L5.step
CAD/PARTS/nut_wheel_L6.step
CAD/PARTS/nut_wheel_R1.step
CAD/PARTS/nut_wheel_R2.step
CAD/PARTS/nut_wheel_R3.step
CAD/PARTS/nut_wheel_R4.step
CAD/PARTS/nut_wheel_R5.step
CAD/PARTS/nut_wheel_R6.step
CAD/PARTS/washer_axle_L.step
CAD/PARTS/washer_axle_R.step
