Hado3728/Hado-Titan-v2/JOURNAL/SCREENSHOT DUMP/ASSEMBLED.png

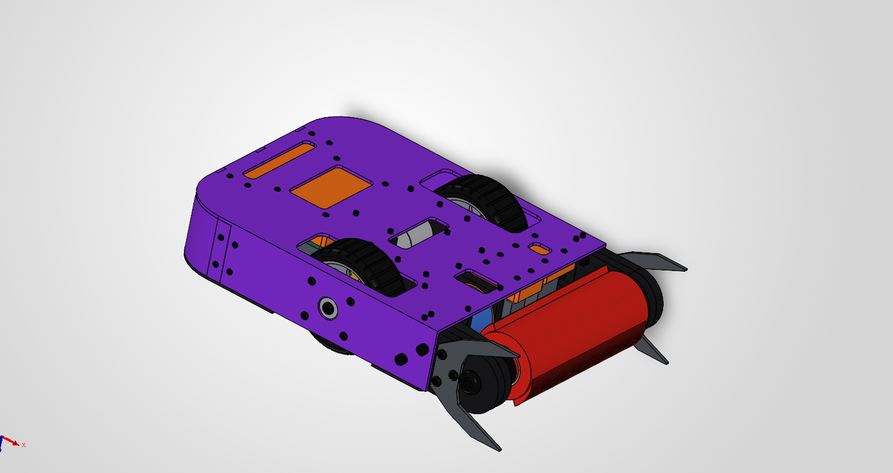
JOURNAL/SCREENSHOT DUMP/ASSEMBLED.png
