Hado3728/Hado-Titan-v2/JOURNAL.md

# 17th October  

So I started working on this project again on the night of the 17th. I'd
actually had this idea of building a battlebot about 1.5 months ago, and I was
pretty inspired by the Nitro BattleBot at that time. I even went out of my way
to contact the owner of the bot, Mr. Andrew, to ask him for some advice on
building one. Thankfully, he actually replied!
His main advice was to focus more on the internal structure and making the
weapon strong rather than just trying to maximise its energy. He also mentioned
how reliability and durability are really important for a successful bot.
Honestly, that was some pretty useful advice, and I wanted to keep it in mind
while designing mine. At this point, I was basically revisiting an idea I'd had
before, but this time I actually wanted to take it all the way to fabrication
instead of just leaving it as an idea.

**Total time spent: 3 hours 30 minutes**

# 18th - 19th October 

Today I started sketching out the bot in my notebook. I was actually on a family
vacation at a hill station, but I still wanted to get some work done, so I took
my notebook along and started roughly figuring out how I wanted the bot to look
and how everything would fit together. The sketches were pretty rough, and I'm




**Total time spent: 8 hours**

# 20th–26th October — Finally Starting the CAD 

Okay, this is where I actually started building the bot instead of just thinking
about it. I started working on the CAD model, and OH MY GOD, it was hectic.
Getting all the components to fit together while keeping the design practical
was a lot harder than I expected. I had to keep going back and forth between
different parts of the design, making adjustments and figuring out how to model
everything properly. I spent almost six full days getting the CAD to a stage
where I was happy with it. I also used Claude to help with some of the modelling
so I could speed things up a bit. It helped me work through certain parts of the
process, but I still had to make sure the overall design worked for the bot I
was trying to build. This part honestly took way longer than I thought it would.
There's a massive difference between imagining a battlebot and actually trying
to fit everything into a model where the components have to work together.












**Total time spent: 40 hours**

# 27th October — Almost Done With the Design 

By 27th, I was pretty much done with the CAD, at least to the point where I
could start preparing the design for fabrication. Before moving forward, though,
I still had to figure out the battery calculations and the gear systems for both
the drive motors and the weapon motor. I didn't want to just finish the CAD and
immediately jump into fabrication without checking these things first. There was
still a lot to consider, especially because the bot needed to be practical to
build and not just look good in a CAD model. So I had the forks to be put into
a 2D stress test and after those I had to like change the design of the forks in
order to  make them strong enough to not break on impact. I did try cutting out 
windows but failed miserably cuz cutting the windows to save on weight made the forks weaker.

fork_designs_fea
fork_fea (1)
**Total time spent: 5 hours**

# `28th October — Cost Cutting and Finalizing Things` 

Today I pitched the bot to my dad, who's a mechanical engineer, to get his
opinion on the design. I wanted him to look at it and suggest ways I could
reduce the cost of fabricating the metal components. After discussing it with
him, I went back and modified quite a few parts of the chassis. One of the main
things I worked on was simplifying the design so that more of the components
could be laser cut instead of requiring CNC machining. This was important
because I didn't want the fabrication costs to get unnecessarily high just
because I'd made the design more complicated than it needed to be. I also
finalised the BOM (Bill of Materials) and started setting up the project
repository on my laptop. I wanted to get the documentation and files organised
instead of having everything scattered around in different folders.

**Total time spent: 4 hours 30 minutes**

# `29th October — Uploading Everything!`

And finally I'm getting everything ready to upload to the repository and pitch
the project on Slack. It's been quite a journey getting from the initial idea to
an actual CAD model with the design and components planned out. I know there's
still a lot left to do, especially once fabrication starts, but I'm really
hoping this goes through. I've put quite a bit of work into getting the design
to this stage, and I genuinely want to see this thing come to life. Now I'm just
hoping the pitch gets accepted so I can move forward with the build.

**Total time spent: 3 hours**

# 14th November - updates on the stuff I have already gotten done 

So I order the laser cut parts, and I have received about 70% of em'. This project was approved today, but I was already done with the designing stage I just needed funding for major electronics components to start building it. I had to de burr all the parts manually, with a hand file. Then I also got the taps for all the screws and I used the hand taps to tap the threads into the parts.




**Total time spent: 2 hours**
