Hado3728/Hado-Titan-v2/JOURNAL/SCREENSHOT DUMP/CAD1.png

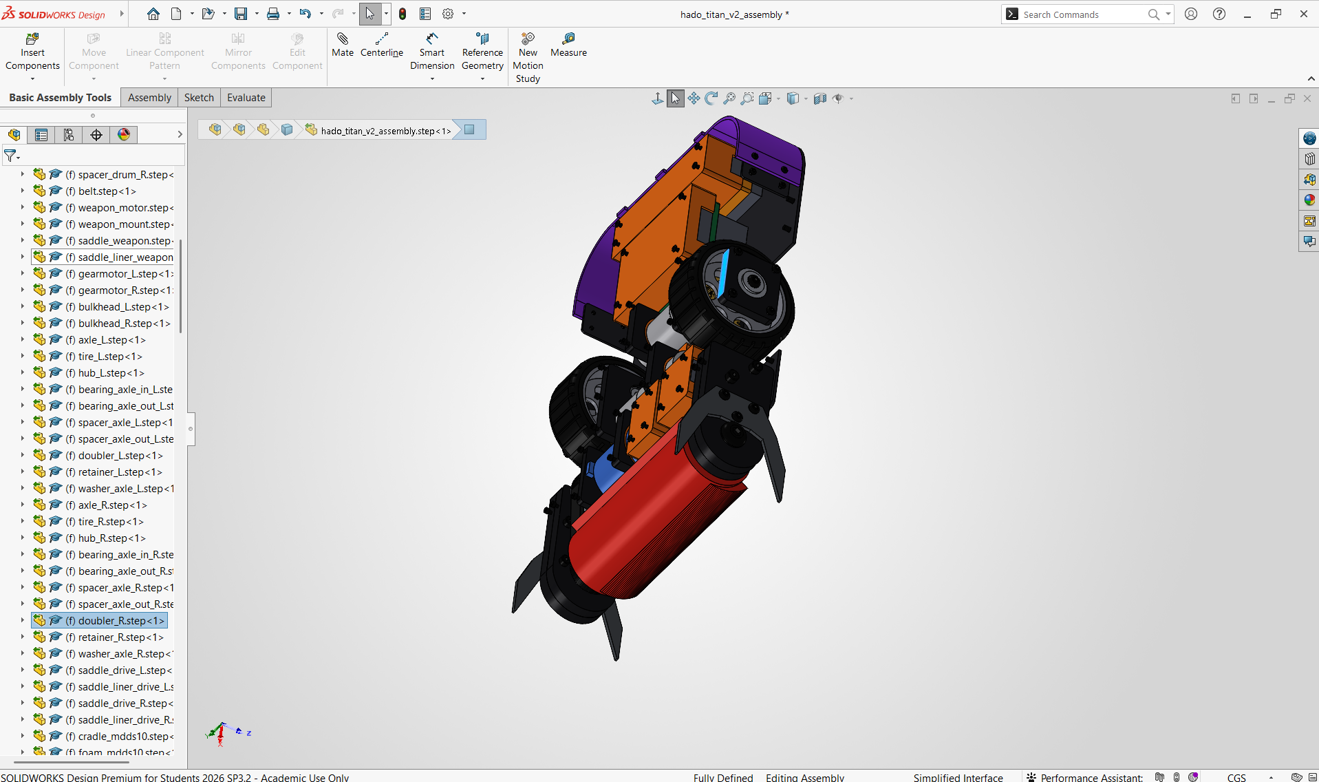
JOURNAL/SCREENSHOT DUMP/CAD1.png
