Hado3728/Hado-Titan-v2/JOURNAL/SCREENSHOT DUMP/DRAWING RETAINER RING.png

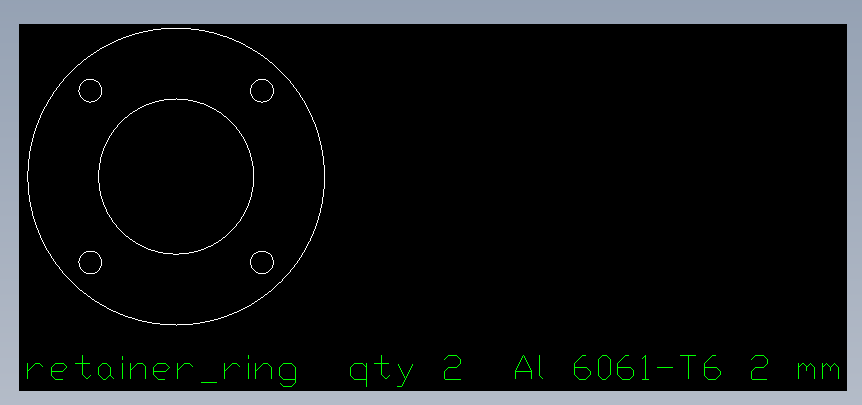
JOURNAL/SCREENSHOT DUMP/DRAWING RETAINER RING.png
