Hado3728/Hado-Titan-v2/JOURNAL/SCREENSHOT DUMP/DRIVE MOTOR 1 of 2 GEAR (L).png

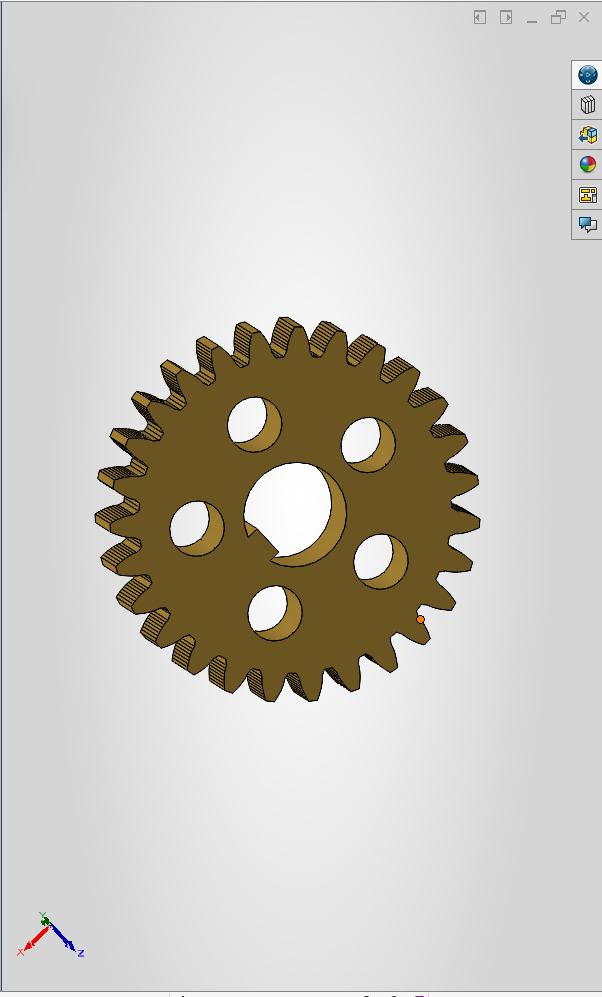
JOURNAL/SCREENSHOT DUMP/DRIVE MOTOR 1 of 2 GEAR (L).png
