Hado3728/Hado-Titan-v2/JOURNAL/SCREENSHOT DUMP/Mr.Andrew's Reply screenshot.png

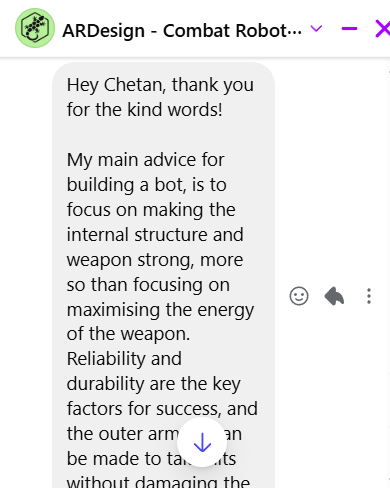
JOURNAL/SCREENSHOT DUMP/Mr.Andrew's Reply screenshot.png
