Hado3728/Hado-Titan-v2/(commit log)

2026-10-29 Added wiring rough diagram, working on Ki CAD
2026-10-30 New CAD files push, fixed weapon pulley system
    [HADO_TITAN_v2_ASSEMBLED.step, drive_plate_L.stl, drive_plate_R.stl, drum.stl, drum_cap_L.stl, drum_cap_R.stl, hado_titan_v2_assembly.step, hub_L.stl]
2026-10-31 Update for final BOM, docs and build notes
    [BOM.xlsx]
2026-11-02 New drum and new fork design update
    [drum.stl, fork_L.stl, fork_R.stl, fork_hook_windows_4mm.stl]
2026-11-03 ADDED NEW 3D PRINT PARTS, AND UPDATED BOM (PROTECTIVE CAPS)
    [BOM.xlsx, drum_tooth_sleeve_TPU_x2.stl, fork_tip_clip_TPU_x4.stl]
2026-11-03 NEW ASSEMBLED CAD, NEW FINS ADDED, NEW SLEEVES FOR PROTECTION ALSO ADDED
    [axle_L.step, axle_L.stl, axle_R.step, axle_R.stl, belt.step, belt.stl, bulkhead_L.step, bulkhead_L.stl]
2026-11-10 Updated BOM, and also uploaded a .csv converted BOM
    [BOM.csv, BOM.xlsx]
2026-11-10 Fine tuning the README.md and added images of the laser cut parts
2026-11-10 Update README with laser cut parts delivery info
    Added information about laser cut parts delivery and included an image.
2026-11-10 Update image in README.md
    Replaced the image of the assembled product with a new screenshot.
2026-11-12 Updated BOM with links for submission
    [BOM.csv, BOM.xlsx]
